WheelsTheCat/SweatyCapy/Schematic.pdf

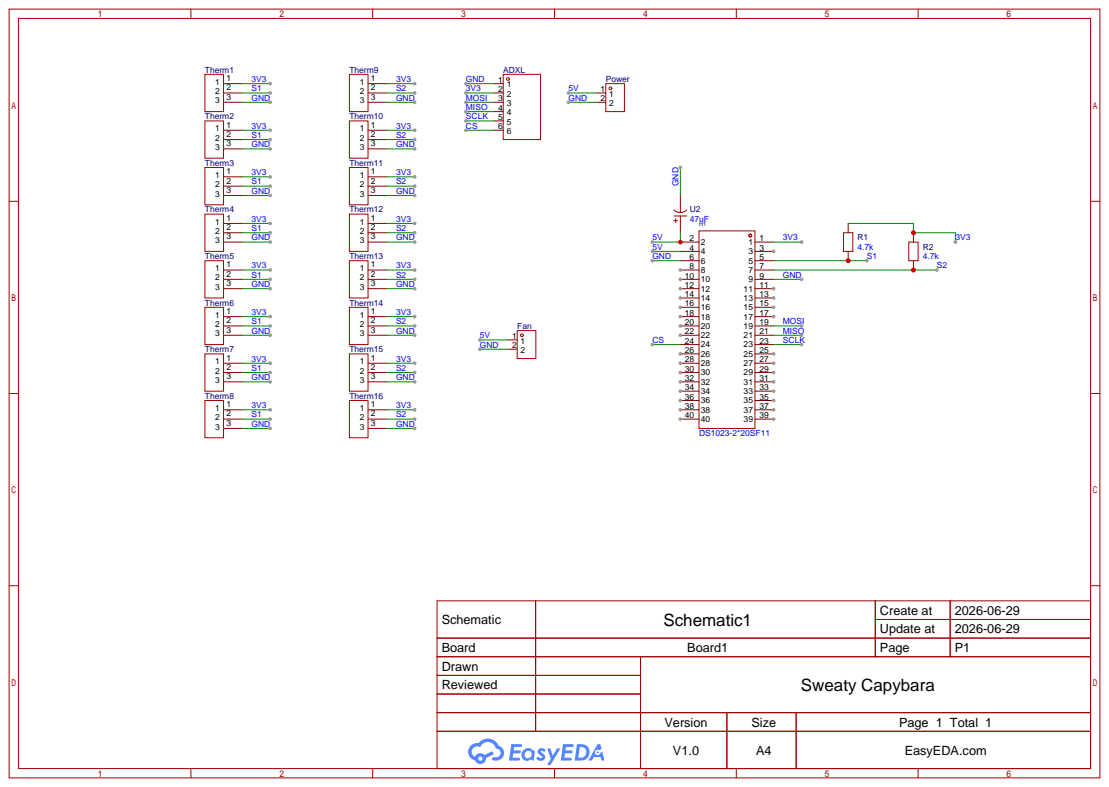
[picture p2: page 1]

Schematic | Schematic1 | Create at | 2026-06-29

Update at | 2026-06-29

Board | Board1 | Page | P1
Drawn | | Sweaty Capybara
Reviewed

Version | Size | Page 1 Total 1
V1.0 | A4 | EasyEDA.com
