WheelsTheCat/SweatyCapy/(commit log)

2026-09-14 inital upload
    [Drill_PTH_Through.DRL, Gerber_BoardOutlineLayer.GKO, Gerber_BottomLayer.GBL, Gerber_BottomSilkscreenLayer.GBO, Gerber_BottomSolderMaskLayer.GBS, Gerber_TopLayer.GTL, Gerber_TopSilkscreenLayer.GTO, Gerber_TopSolderMaskLayer.GTS]
2026-09-14 Add generic BOM
